Yatekii/pebble/hardware/pebble.kicad_pcb

## KiCad design hardware/pebble.kicad_pcb (2025-12-16)

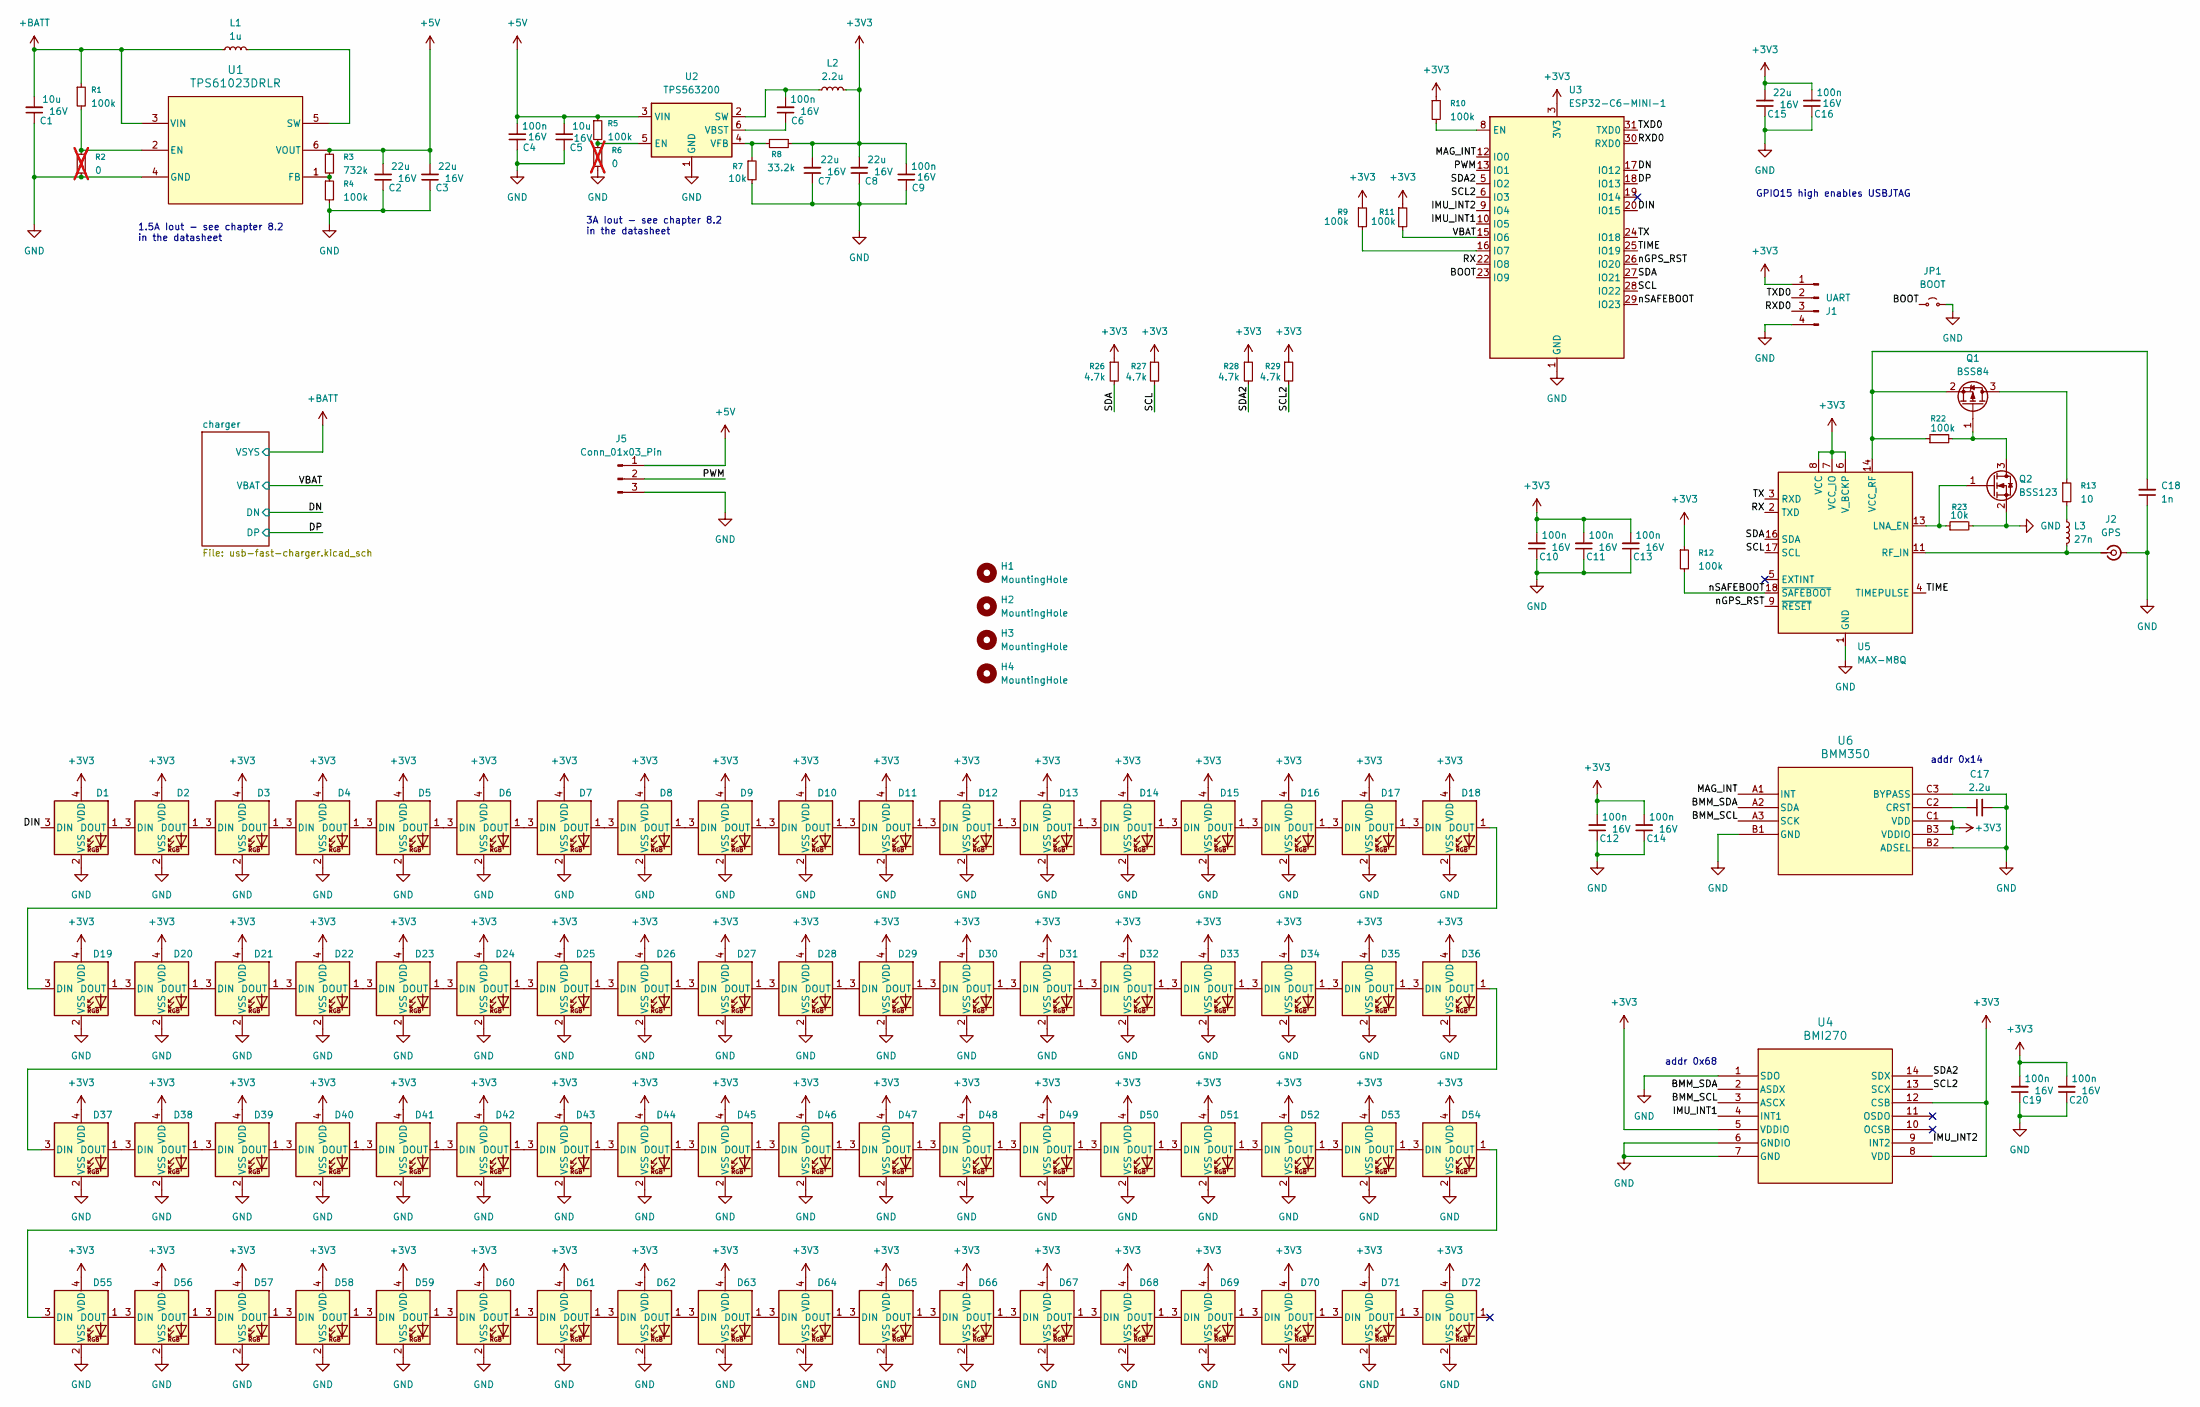
[picture p1: schematic pebble.kicad_sch]

Parts:
C1, C5: 10u; C_0603_1608Metric; Rating 16V
C2, C3, C7, C8, C15: 22u; C_0603_1608Metric; Rating 16V
C4, C6, C9, C10, C11, C12, C13, C14, C16, C19, C20: 100n; C_0402_1005Metric; Rating 16V
C17: 2.2u; C_0402_1005Metric
C18: 1n; C_0402_1005Metric
D1: WS2812B-2020; LED_WS2812B-2020_PLCC4_2.0x2.0mm; LCSC Part # C965555
D2, D3, D4, D5, D6, D7, D8, D9, D10, D11, D12, D13, D14, D15, D16, D17, D18, D19, D20, D21, D22, D23, D24, D25, D26, D27, D28, D29, D30, D31, D32, D33, D34, D35, D36, D37, D38, D39, D40, D41, D42, D43, D44, D45, D46, D47, D48, D49, D50, D51, D52, D53, D54, D55, D56, D57, D58, D59, D60, D61, D62, D63, D64, D65, D66, D67, D68, D69, D70, D71, D72: WS2812B-2020; LED_WS2812B-2020_PLCC4_2.0x2.0mm
H1, H2, H3, H4: MountingHole; MountingHole_3.2mm_M3
J1: UART; PinHeader_1x04_P1.27mm_Vertical
J2: GPS; U.FL_Molex_MCRF_73412-0110_Vertical; LCSC Part # C22418213
J5: Conn_01x03_Pin; PinHeader_1x03_P1.27mm_Horizontal
JP1: BOOT; TestPoint_2Pads_Pitch2.54mm_Drill0.8mm
L1: 1u; L_Coilcraft_XxL4040; Part XEL4030-102MEC
L2: 2.2u; IND_SPM6530_TDK
L3: 27n; L_0402_1005Metric_Pad0.77x0.64mm_HandSolder; Part LQG15HS27NJ02
Q1: BSS84; SOT-23; LCSC Part # Part # C7420340
Q2: BSS123; SOT-23; LCSC Part # C7420338
R1, R4, R5, R9, R10, R11, R12, R22: 100k; R_0402_1005Metric
R2, R6: 0; R_0402_1005Metric; not fitted
R3: 732k; R_0402_1005Metric
R7, R23: 10k; R_0402_1005Metric
R8: 33.2k; R_0402_1005Metric
R13: 10; R_0402_1005Metric
R26, R27, R28, R29: 4.7k; R_0402_1005Metric
U1: TPS61023DRLR; SOT-563; LCSC Part # C919459
U2: TPS563200; SOT-23-6; Part SPM6530T-2R2M; LCSC Part # C97253
U3: ESP32-C6-MINI-1; LCSC Part # C5736265
U4: BMI270; BMI270_BOS; LCSC Part # C2836813
U5: MAX-M8Q; ublox_MAX; LCSC Part # C6898733
U6: BMM350; BGA9_BMM350_BOS; LCSC Part # C17225907

Connections:
+3V3: C7.2, C8.2, C9.2, C10.2, C11.2, C12.2, C13.2, C14.2, C15.2, C16.2, C19.2, C20.2, D1.4 (VDD), D2.4 (VDD), D3.4 (VDD), D4.4 (VDD), D5.4 (VDD), D6.4 (VDD), D7.4 (VDD), D8.4 (VDD), D9.4 (VDD), D10.4 (VDD), D11.4 (VDD), D12.4 (VDD), D13.4 (VDD), D14.4 (VDD), D15.4 (VDD), D16.4 (VDD), D17.4 (VDD), D18.4 (VDD), D19.4 (VDD), D20.4 (VDD), D21.4 (VDD), D22.4 (VDD), D23.4 (VDD), D24.4 (VDD), D25.4 (VDD), D26.4 (VDD), D27.4 (VDD), D28.4 (VDD), D29.4 (VDD), D30.4 (VDD), D31.4 (VDD), D32.4 (VDD), D33.4 (VDD), D34.4 (VDD), D35.4 (VDD), D36.4 (VDD), D37.4 (VDD), D38.4 (VDD), D39.4 (VDD), D40.4 (VDD), D41.4 (VDD), D42.4 (VDD), D43.4 (VDD), D44.4 (VDD), D45.4 (VDD), D46.4 (VDD), D47.4 (VDD), D48.4 (VDD), D49.4 (VDD), D50.4 (VDD), D51.4 (VDD), D52.4 (VDD), D53.4 (VDD), D54.4 (VDD), D55.4 (VDD), D56.4 (VDD), D57.4 (VDD), D58.4 (VDD), D59.4 (VDD), D60.4 (VDD), D61.4 (VDD), D62.4 (VDD), D63.4 (VDD), D64.4 (VDD), D65.4 (VDD), D66.4 (VDD), D67.4 (VDD), D68.4 (VDD), D69.4 (VDD), D70.4 (VDD), D71.4 (VDD), D72.4 (VDD), J1.1, L2.2, R8.1, R9.1, R10.1, R11.1, R12.1, R26.1, R27.1, R28.1, R29.1, U3.3 (3V3), U4.5 (VDDIO), U4.8 (VDD), U4.12 (CSB), U5.6 (V_BCKP), U5.7 (VCC_IO), U5.8 (VCC), U6.B3 (VDDIO), U6.C1 (VDD); also elsewhere on the board
+5V: C2.2, C3.2, C4.2, C5.2, J5.1, R3.1, R5.1, U1.6 (VOUT), U2.3 (VIN)
+BATT: C1.2, L1.1, R1.1, U1.3 (VIN); also elsewhere on the board
/BMM_SCL: U4.3 (ASCX), U6.A3 (SCK)
/BMM_SDA: U4.2 (ASDX), U6.A2 (SDA)
/BOOT: JP1.1 (A), U3.23 (IO9)
/DIN: D1.3 (DIN), U3.20 (IO15)
/DN: U3.17 (IO12); also elsewhere on the board
/DP: U3.18 (IO13); also elsewhere on the board
/IMU_INT1: U3.10 (IO5), U4.4 (INT1)
/IMU_INT2: U3.9 (IO4), U4.9 (INT2)
/MAG_INT: U3.12 (IO0), U6.A1 (INT)
/PWM: J5.2, U3.13 (IO1)
/RX: U3.22 (IO8), U5.2 (TXD)
/RXD0: J1.3, U3.30 (RXD0)
/SCL: R27.2, U3.28 (IO22), U5.17 (SCL)
/SCL2: R29.2, U3.6 (IO3), U4.13 (SCX)
/SDA: R26.2, U3.27 (IO21), U5.16 (SDA)
/SDA2: R28.2, U3.5 (IO2), U4.14 (SDX)
/TIME: U3.25 (IO19), U5.4 (TIMEPULSE)
/TX: U3.24 (IO18), U5.3 (RXD)
/TXD0: J1.2, U3.31 (TXD0)
/VBAT: R11.2, U3.15 (IO6); also elsewhere on the board
/nGPS_RST: U3.26 (IO20), U5.9 (~RESET)
/nSAFEBOOT: R12.2, U3.29 (IO23), U5.18 (~SAFEBOOT)
GND: C1.1, C2.1, C3.1, C4.1, C5.1, C7.1, C8.1, C9.1, C10.1, C11.1, C12.1, C13.1, C14.1, C15.1, C16.1, C17.2, C18.1, C19.1, C20.1, D1.2 (VSS), D2.2 (VSS), D3.2 (VSS), D4.2 (VSS), D5.2 (VSS), D6.2 (VSS), D7.2 (VSS), D8.2 (VSS), D9.2 (VSS), D10.2 (VSS), D11.2 (VSS), D12.2 (VSS), D13.2 (VSS), D14.2 (VSS), D15.2 (VSS), D16.2 (VSS), D17.2 (VSS), D18.2 (VSS), D19.2 (VSS), D20.2 (VSS), D21.2 (VSS), D22.2 (VSS), D23.2 (VSS), D24.2 (VSS), D25.2 (VSS), D26.2 (VSS), D27.2 (VSS), D28.2 (VSS), D29.2 (VSS), D30.2 (VSS), D31.2 (VSS), D32.2 (VSS), D33.2 (VSS), D34.2 (VSS), D35.2 (VSS), D36.2 (VSS), D37.2 (VSS), D38.2 (VSS), D39.2 (VSS), D40.2 (VSS), D41.2 (VSS), D42.2 (VSS), D43.2 (VSS), D44.2 (VSS), D45.2 (VSS), D46.2 (VSS), D47.2 (VSS), D48.2 (VSS), D49.2 (VSS), D50.2 (VSS), D51.2 (VSS), D52.2 (VSS), D53.2 (VSS), D54.2 (VSS), D55.2 (VSS), D56.2 (VSS), D57.2 (VSS), D58.2 (VSS), D59.2 (VSS), D60.2 (VSS), D61.2 (VSS), D62.2 (VSS), D63.2 (VSS), D64.2 (VSS), D65.2 (VSS), D66.2 (VSS), D67.2 (VSS), D68.2 (VSS), D69.2 (VSS), D70.2 (VSS), D71.2 (VSS), D72.2 (VSS), J1.4, J2.2 (Ext), J5.3, JP1.2 (B), Q2.2 (S), R2.2, R4.2, R6.2, R7.2, R23.2, U1.4 (GND), U2.1 (GND), U3.1 (GND), U3.2 (GND), U3.11 (GND), U3.14 (GND), U3.36 (GND), U3.37 (GND), U3.38 (GND), U3.39 (GND), U3.40 (GND), U3.41 (GND), U3.42 (GND), U3.43 (GND), U3.44 (GND), U3.45 (GND), U3.46 (GND), U3.47 (GND), U3.48 (GND), U3.49 (GND), U3.50 (GND), U3.51 (GND), U3.52 (GND), U3.53 (GND), U4.1 (SDO), U4.6 (GNDIO), U4.7 (GND), U5.1 (GND), U5.10 (GND), U5.12 (GND), U6.B1 (GND), U6.B2 (ADSEL), U6.C3 (BYPASS); also elsewhere on the board
unnamed: D1.1 (DOUT), D2.3 (DIN)
unnamed: D2.1 (DOUT), D3.3 (DIN)
unnamed: D3.1 (DOUT), D4.3 (DIN)
unnamed: D4.1 (DOUT), D5.3 (DIN)
unnamed: D5.1 (DOUT), D6.3 (DIN)
unnamed: D6.1 (DOUT), D7.3 (DIN)
unnamed: D7.1 (DOUT), D8.3 (DIN)
unnamed: D8.1 (DOUT), D9.3 (DIN)
unnamed: D9.1 (DOUT), D10.3 (DIN)
unnamed: D10.1 (DOUT), D11.3 (DIN)
unnamed: D11.1 (DOUT), D12.3 (DIN)
unnamed: D12.1 (DOUT), D13.3 (DIN)
unnamed: D13.1 (DOUT), D14.3 (DIN)
unnamed: D14.1 (DOUT), D15.3 (DIN)
unnamed: D15.1 (DOUT), D16.3 (DIN)
unnamed: D16.1 (DOUT), D17.3 (DIN)
unnamed: D17.1 (DOUT), D18.3 (DIN)
unnamed: D18.1 (DOUT), D19.3 (DIN)
unnamed: D19.1 (DOUT), D20.3 (DIN)
unnamed: D20.1 (DOUT), D21.3 (DIN)
unnamed: D21.1 (DOUT), D22.3 (DIN)
unnamed: D22.1 (DOUT), D23.3 (DIN)
unnamed: D23.1 (DOUT), D24.3 (DIN)
unnamed: D24.1 (DOUT), D25.3 (DIN)
unnamed: D25.1 (DOUT), D26.3 (DIN)
unnamed: D26.1 (DOUT), D27.3 (DIN)
unnamed: D27.1 (DOUT), D28.3 (DIN)
unnamed: D28.1 (DOUT), D29.3 (DIN)
unnamed: D29.1 (DOUT), D30.3 (DIN)
unnamed: D30.1 (DOUT), D31.3 (DIN)
unnamed: D31.1 (DOUT), D32.3 (DIN)
unnamed: D32.1 (DOUT), D33.3 (DIN)
unnamed: D33.1 (DOUT), D34.3 (DIN)
unnamed: D34.1 (DOUT), D35.3 (DIN)
unnamed: D35.1 (DOUT), D36.3 (DIN)
unnamed: D36.1 (DOUT), D37.3 (DIN)
unnamed: D37.1 (DOUT), D38.3 (DIN)
unnamed: D38.1 (DOUT), D39.3 (DIN)
unnamed: D39.1 (DOUT), D40.3 (DIN)
unnamed: D40.1 (DOUT), D41.3 (DIN)
unnamed: D41.1 (DOUT), D42.3 (DIN)
unnamed: D42.1 (DOUT), D43.3 (DIN)
unnamed: D43.1 (DOUT), D44.3 (DIN)
unnamed: D44.1 (DOUT), D45.3 (DIN)
unnamed: D45.1 (DOUT), D46.3 (DIN)
unnamed: D46.1 (DOUT), D47.3 (DIN)
unnamed: D47.1 (DOUT), D48.3 (DIN)
unnamed: D48.1 (DOUT), D49.3 (DIN)
unnamed: D49.1 (DOUT), D50.3 (DIN)
unnamed: D50.1 (DOUT), D51.3 (DIN)
unnamed: D51.1 (DOUT), D52.3 (DIN)
unnamed: D52.1 (DOUT), D53.3 (DIN)
unnamed: D53.1 (DOUT), D54.3 (DIN)
unnamed: D54.1 (DOUT), D55.3 (DIN)
unnamed: D55.1 (DOUT), D56.3 (DIN)
unnamed: D56.1 (DOUT), D57.3 (DIN)
unnamed: D57.1 (DOUT), D58.3 (DIN)
unnamed: D58.1 (DOUT), D59.3 (DIN)
unnamed: D59.1 (DOUT), D60.3 (DIN)
unnamed: D60.1 (DOUT), D61.3 (DIN)
unnamed: D61.1 (DOUT), D62.3 (DIN)
unnamed: D62.1 (DOUT), D63.3 (DIN)
unnamed: D63.1 (DOUT), D64.3 (DIN)
unnamed: D64.1 (DOUT), D65.3 (DIN)
unnamed: D65.1 (DOUT), D66.3 (DIN)
unnamed: D66.1 (DOUT), D67.3 (DIN)
unnamed: D67.1 (DOUT), D68.3 (DIN)
unnamed: D68.1 (DOUT), D69.3 (DIN)
unnamed: D69.1 (DOUT), D70.3 (DIN)
unnamed: D70.1 (DOUT), D71.3 (DIN)
unnamed: D71.1 (DOUT), D72.3 (DIN)
unnamed: J2.1 (In), L3.2, U5.11 (RF_IN)
unnamed: L3.1, R13.2
unnamed: Q1.3 (D), R13.1
unnamed: Q1.1 (G), Q2.3 (D), R22.2
unnamed: C18.2, Q1.2 (S), R22.1, U5.14 (VCC_RF)
unnamed: Q2.1 (G), R23.1, U5.13 (LNA_EN)
unnamed: R1.2, R2.1, U1.2 (EN)
unnamed: R3.2, R4.1, U1.1 (FB)
unnamed: L1.2, U1.5 (SW)
unnamed: R5.2, R6.1, U2.5 (EN)
unnamed: C6.2, L2.1, U2.2 (SW)
unnamed: C6.1, U2.6 (VBST)
unnamed: R7.1, R8.2, U2.4 (VFB)
unnamed: R10.2, U3.8 (EN)
unnamed: R9.2, U3.16 (IO7)
unnamed: C17.1, U6.C2 (CRST)

Notes on the sheet:
addr 0x14
GPIO15 high enables USBJTAG
3A Iout - see chapter 8.2 in the datasheet
1.5A Iout - see chapter 8.2 in the datasheet
addr 0x68

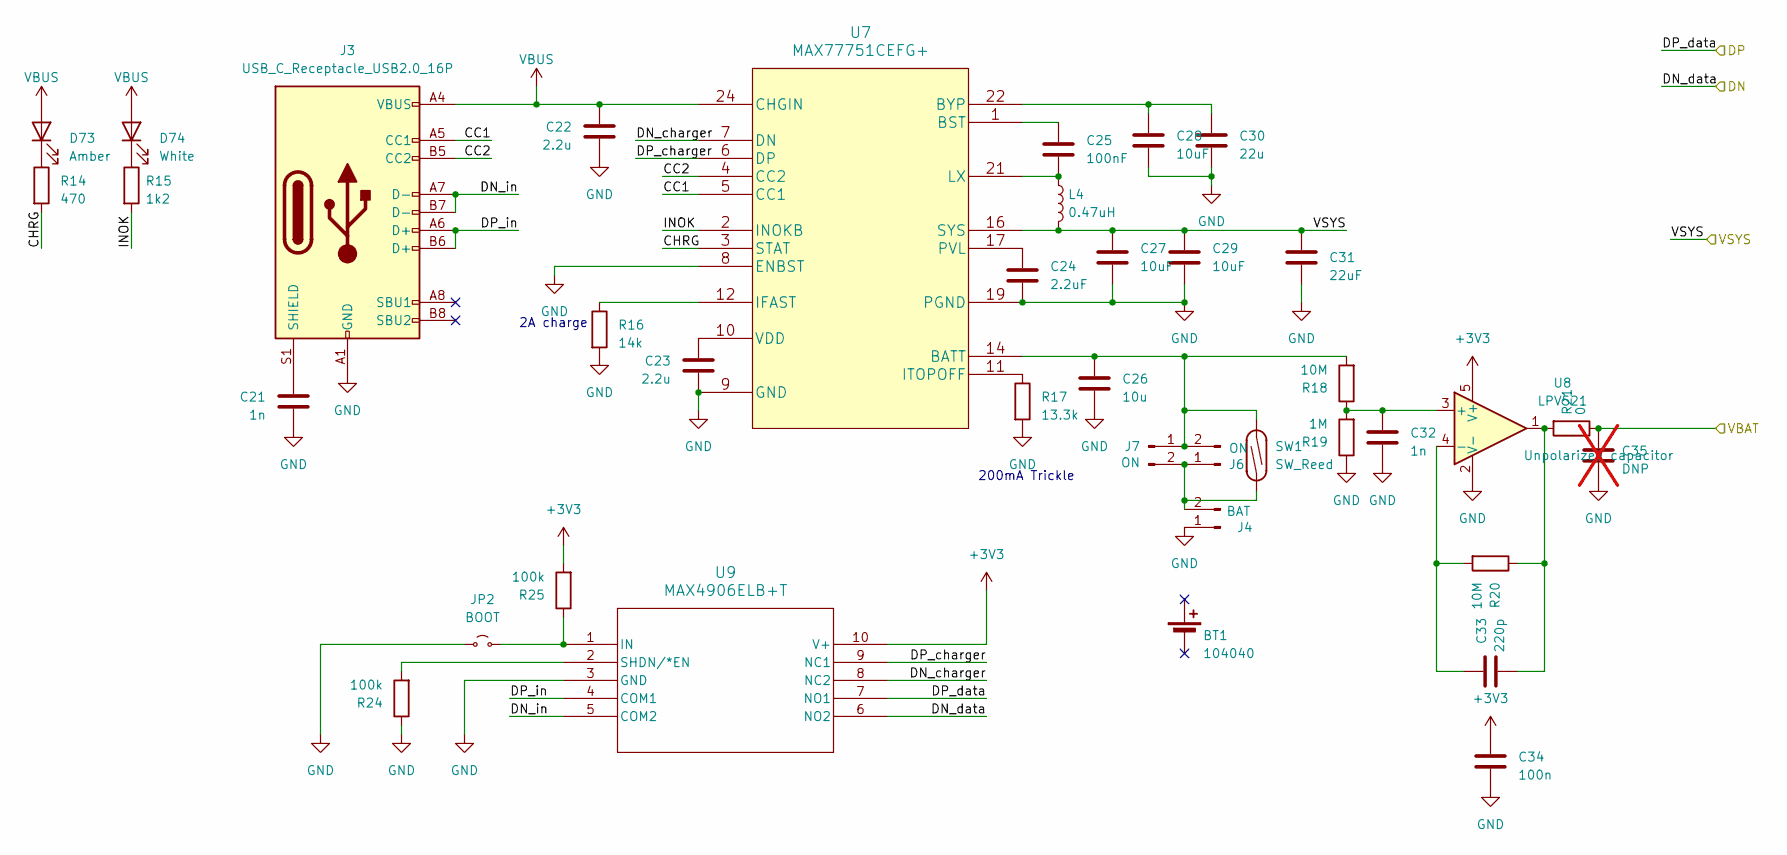
[picture p2: schematic usb-fast-charger.kicad_sch]

Parts:
BT1: 104040; JST_PH_S2B-PH-SM4-TB_1x02-1MP_P2.00mm_Horizontal
C21: 1n; C_1206_3216Metric; Voltage 2000; Mouser 80-C1206C102KGR
C22, C23: 2.2u; C_0402_1005Metric; Voltage 16; Mouser 346-CM05X5R225M16AH
C24: 2.2uF; C_0402_1005Metric; Voltage 16; Mouser 346-CM05X5R225M16AH
C25: 100nF; C_0402_1005Metric; Voltage 25V
C26: 10u; C_0805_2012Metric; Voltage 16; Mouser 187-CL21A106KOQNNNE
C27, C28, C29: 10uF; C_0805_2012Metric; Voltage 16; Mouser 187-CL21A106KOQNNNE
C30: 22u; C_0805_2012Metric; Voltage 16; Mouser 187-CL21A226MOQNNNE
C31: 22uF; C_0805_2012Metric; Voltage 16; Mouser 187-CL21A226MOQNNNE
C32: 1n; C_0402_1005Metric; Voltage 25V
C33: 220p; C_0402_1005Metric; Voltage 25V
C34: 100n; C_0402_1005Metric; Voltage 25V
C35: DNP; C_0402_1005Metric; Voltage 25V; not fitted
D73: Amber; LED_0603_1608Metric; Mouser 710-150060AS75000
D74: White; LED_0603_1608Metric; Mouser 78-VLMW1300-GS08
J3: USB_C_Receptacle_USB2.0_16P; USB_C_Receptacle_G-Switch_GT-USB-7051x; LCSC Part # C2843970
J4: BAT; PinHeader_1x02_P1.27mm_Vertical
J6, J7: ON; PinHeader_1x02_P1.27mm_Vertical
JP2: BOOT; TestPoint_2Pads_Pitch2.54mm_Drill0.8mm
L4: 0.47uH; IND_SRP2512TMA_BRN; Mouser 652-SRP2512TMA-R47M
R14: 470; R_0402_1005Metric
R15: 1k2; R_0402_1005Metric
R16: 14k; R_0402_1005Metric; Mouser 603-AC0402FR-0714KL
R17: 13.3k; R_0402_1005Metric; Mouser 603-RC0402FR-0713K3L
R18, R20: 10M; R_0402_1005Metric; Mouser 603-AC0402FR-0710ML
R19: 1M; R_0402_1005Metric; Mouser 603-AC0402FR-071ML
R21: 0; R_0402_1005Metric
R24, R25: 100k; R_0402_1005Metric; Mouser 603-AC0402FR-071ML
SW1: SW_Reed; 59170-1-S-00-D; LCSC Part # C315909
U7: MAX77751CEFG+; LCSC Part # C2908590
U8: LPV521; SOT-23-5; LCSC Part # C779403
U9: MAX4906ELB+T; 21-0164_L1022&plus_1_MXM; LCSC Part # C2150885

Connections:
+3V3: C34.1, R25.2, U8.5 (V+), U9.10 (V+); also elsewhere on the board
+BATT: C27.1, C29.1, C31.1, L4.2, U7.15 (SYS), U7.16 (SYS); also elsewhere on the board
/DN: U9.6 (NO2); also elsewhere on the board
/DP: U9.7 (NO1); also elsewhere on the board
/VBAT: C35.1, R21.1; also elsewhere on the board
/charger/CC1: J3.A5 (CC1), U7.5 (CC1)
/charger/CC2: J3.B5 (CC2), U7.4 (CC2)
/charger/CHRG: R14.2, U7.3 (STAT)
/charger/DN_charger: U7.7 (DN), U9.8 (NC2)
/charger/DN_in: J3.A7 (D-), J3.B7 (D-), U9.5 (COM2)
/charger/DP_charger: U7.6 (DP), U9.9 (NC1)
/charger/DP_in: J3.A6 (D+), J3.B6 (D+), U9.4 (COM1)
/charger/INOK: R15.2, U7.2 (INOKB)
GND: C21.2, C22.2, C23.2, C24.2, C26.2, C27.2, C28.2, C29.2, C30.2, C31.2, C32.2, C34.2, C35.2, J3.A1 (GND), J3.A12 (GND), J3.B1 (GND), J3.B12 (GND), J4.1, JP2.1 (A), R16.2, R17.2, R19.1, R24.1, U7.8 (ENBST), U7.9 (GND), U7.18 (PGND), U7.19 (PGND), U8.2 (V-), U9.3 (GND); also elsewhere on the board
unnamed: C25.2, L4.1, U7.20 (LX), U7.21 (LX)
unnamed: C33.1, R20.1, R21.2, U8.1
unnamed: D73.1 (K), R14.1
unnamed: D74.1 (K), R15.1
unnamed: C21.1, J3.S1 (SHIELD)
unnamed: J4.2, J6.1, J7.2, SW1.2
unnamed: C26.1, J6.2, J7.1, R18.2, SW1.1, U7.13 (BATT), U7.14 (BATT)
unnamed: JP2.2 (B), R25.1, U9.1 (IN)
unnamed: C25.1, U7.1 (BST)
unnamed: C28.1, C30.1, U7.22 (BYP)
unnamed: R16.1, U7.12 (IFAST)
unnamed: R17.1, U7.11 (ITOPOFF)
unnamed: C24.1, U7.17 (PVL)
unnamed: C23.1, U7.10 (VDD)
unnamed: C32.1, R18.1, R19.2, U8.3 (+)
unnamed: C33.2, R20.2, U8.4 (-)
unnamed: R24.2, U9.2 (SHDN/*EN)
VBUS: C22.1, D73.2 (A), D74.2 (A), J3.A4 (VBUS), J3.A9 (VBUS), J3.B4 (VBUS), J3.B9 (VBUS), U7.23 (CHGIN), U7.24 (CHGIN)

Notes on the sheet:
200mA Trickle
2A charge

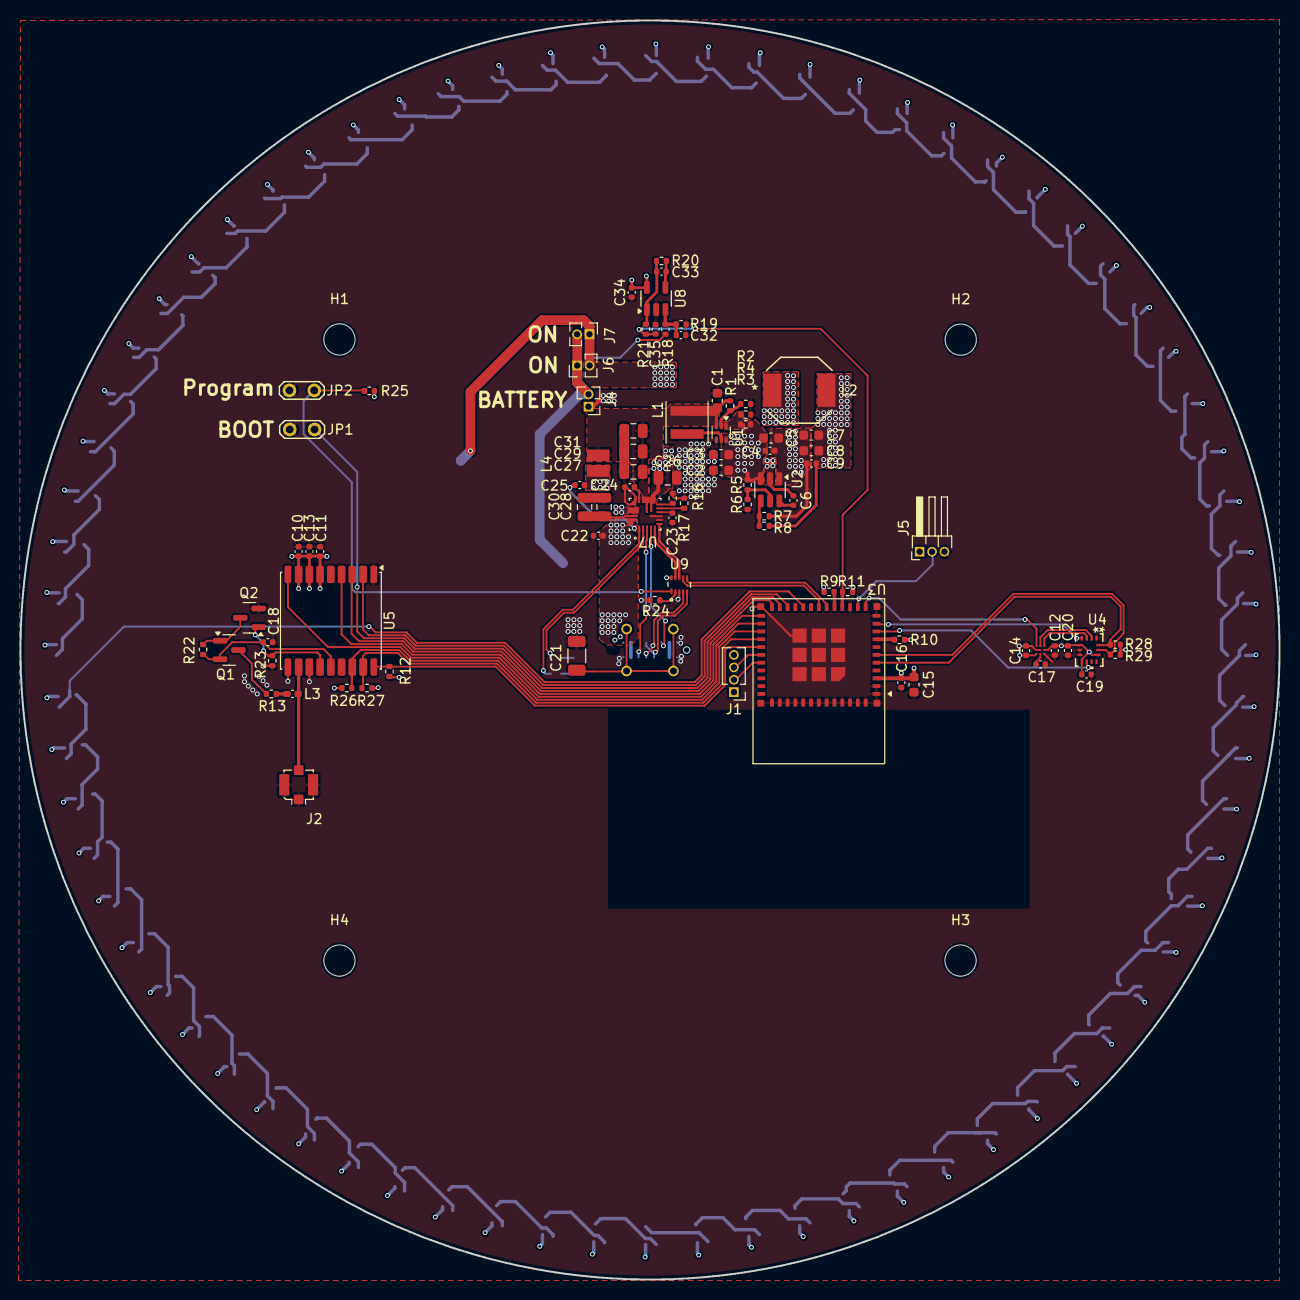
[picture p3: board pebble.kicad_pcb from above]

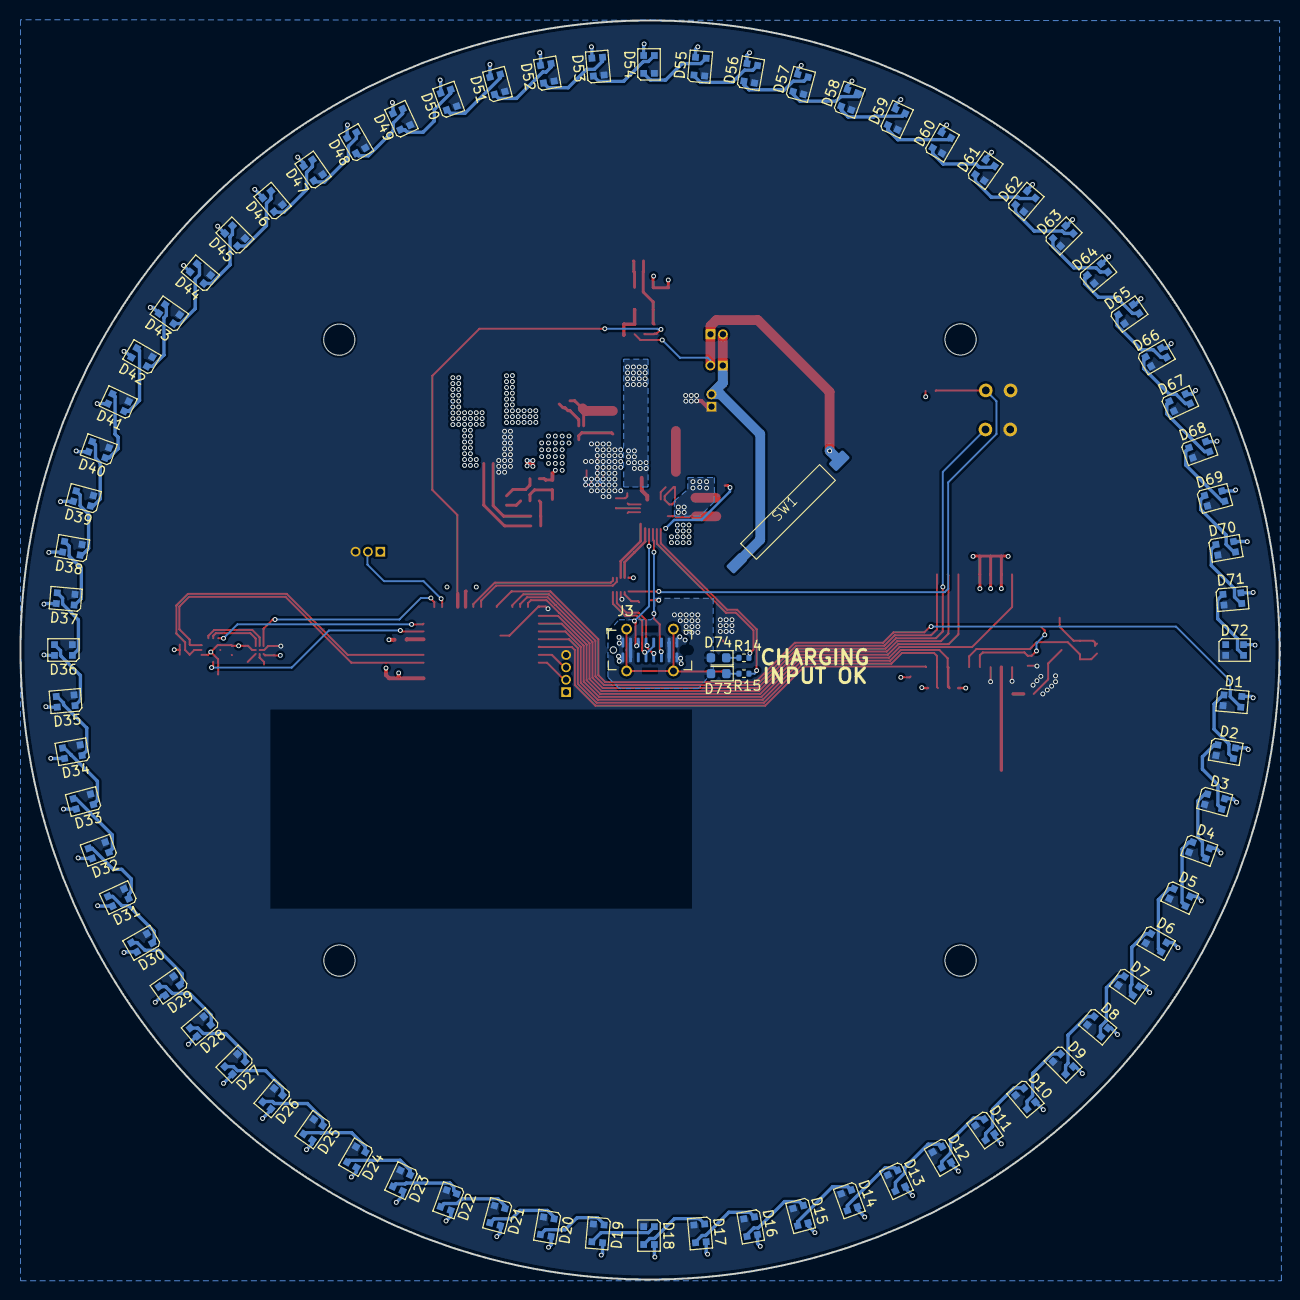
[picture p4: board pebble.kicad_pcb from below]

Board: 4 copper layers, 129.0 x 129.0 mm, 167 parts (78 on the bottom side), 139 nets.
