Yatekii/pebble/firmware/src/hal/gps.rs

//! GPS driver for MAX-M8Q module
//!
//! Datasheet: https://www.u-blox.com/sites/default/files/MAX-M8-FW3_DataSheet_%28UBX-15031506%29.pdf
//!
//! The GPS communicates via UART at 9600 baud (default).
//! GPIO8 = RX (from GPS TXD), GPIO18 = TX (to GPS RXD).
//! This module handles UART communication and uses the `nmea` crate for parsing.

use chrono::{Datelike, Timelike};
use defmt::Format;
use esp_hal::Blocking;
use esp_hal::uart::{Config as UartConfig, RxConfig, TxConfig, Uart};
use nmea::Nmea;
use nmea::SentenceType;
use nmea::sentences::FixType as NmeaFixType;

/// GPS driver using FIFO polling
pub struct Gps<'d> {
    _uart: Uart<'d, Blocking>,
    nmea: Nmea,
    ubx_parser: UbxParser,
    line_buffer: [u8; 128],
    line_pos: usize,
}

impl<'d> Gps<'d> {
    /// Poll FIFO and parse any available GPS data
    /// Returns Some(GpsData) when a complete sentence updates the fix
    pub fn poll(&mut self) -> Option<GpsData> {
        let uart1 = unsafe { &*esp_hal::peripherals::UART1::ptr() };

        let mut result = None;
        while uart1.status().read().rxfifo_cnt().bits() > 0 {
            let byte = uart1.fifo().read().rxfifo_rd_byte().bits();

            // Try UBX parsing for binary responses
            self.ubx_parser.process(byte);

            // Buffer NMEA sentences
            if byte == b'$' {
                self.line_pos = 0;
            }

            if self.line_pos < self.line_buffer.len() {
                self.line_buffer[self.line_pos] = byte;
                self.line_pos += 1;
            }

            // Check for end of NMEA sentence
            if byte == b'\n' && self.line_pos > 1 {
                if let Ok(sentence) = core::str::from_utf8(&self.line_buffer[..self.line_pos]) {
                    let sentence = sentence.trim();

                    // Fix GSV sentences with 0 satellites - nmea crate expects trailing comma
                    // e.g., "$GPGSV,1,1,00*79" -> "$GPGSV,1,1,00,*XX" with recalculated checksum
                    let mut fixed_buf = [0u8; 140];
                    let parse_sentence = if sentence.contains("GSV") && sentence.contains(",00*") {
                        if let Some(star_idx) = sentence.find('*') {
                            // Get data between $ and *, add comma after it
                            let data = &sentence[1..star_idx];
                            let new_data_len = data.len() + 1; // +1 for added comma

                            // Build: $<data>,*<checksum>
                            fixed_buf[0] = b'$';
                            fixed_buf[1..1 + data.len()].copy_from_slice(data.as_bytes());
                            fixed_buf[1 + data.len()] = b',';
                            fixed_buf[2 + data.len()] = b'*';

                            // Calculate new checksum (XOR of bytes between $ and *)
                            let mut checksum: u8 = 0;
                            for &b in &fixed_buf[1..1 + new_data_len] {
                                checksum ^= b;
                            }

                            // Write checksum as hex
                            let hex_chars = b"0123456789ABCDEF";
                            fixed_buf[3 + data.len()] = hex_chars[(checksum >> 4) as usize];
                            fixed_buf[4 + data.len()] = hex_chars[(checksum & 0xF) as usize];

                            let total_len = 5 + data.len();
                            core::str::from_utf8(&fixed_buf[..total_len]).unwrap_or(sentence)
                        } else {
                            sentence
                        }
                    } else {
                        sentence
                    };

                    match self.nmea.parse(parse_sentence) {
                        Ok(_) => {
                            result = Some(self.to_gps_data());
                        }
                        Err(e) => {
                            defmt::warn!(
                                "NMEA parse error for '{}': {:?}",
                                sentence,
                                defmt::Debug2Format(&e)
                            );
                        }
                    }
                }
                self.line_pos = 0;
            }
        }

        result
    }

    /// Get the current GPS data
    pub fn data(&self) -> GpsData {
        self.to_gps_data()
    }

    /// Convert nmea state to GpsData
    fn to_gps_data(&self) -> GpsData {
        use nmea::sentences::GnssType as NmeaGnssType;

        let fix_quality = match self.nmea.fix_type {
            Some(NmeaFixType::Invalid) | None => FixQuality::Invalid,
            Some(NmeaFixType::Gps) => FixQuality::GpsFix,
            Some(NmeaFixType::DGps) => FixQuality::DgpsFix,
            Some(NmeaFixType::Pps) => FixQuality::PpsFix,
            Some(NmeaFixType::Rtk) => FixQuality::RtkFixed,
            Some(NmeaFixType::FloatRtk) => FixQuality::RtkFloat,
            Some(NmeaFixType::Estimated) => FixQuality::Estimated,
            Some(NmeaFixType::Manual) => FixQuality::Manual,
            Some(NmeaFixType::Simulation) => FixQuality::Simulation,
        };

        // Determine fix type from HDOP/altitude availability as proxy for 2D/3D
        let fix_type = if self.nmea.hdop.is_some() && self.nmea.altitude.is_some() {
            FixType::Fix3D
        } else if self.nmea.hdop.is_some() {
            FixType::Fix2D
        } else {
            FixType::NoFix
        };

        // Get satellites from GSV data
        let nmea_sats = self.nmea.satellites();
        let satellites_in_view = nmea_sats.len().min(MAX_SATELLITES) as u8;

        // Convert satellite info
        let mut satellites_info = [SatelliteInfo::default(); MAX_SATELLITES];
        for (i, sat) in nmea_sats.iter().take(MAX_SATELLITES).enumerate() {
            let gnss_type = match sat.gnss_type() {
                NmeaGnssType::Gps => GnssType::Gps,
                NmeaGnssType::Glonass => GnssType::Glonass,
                NmeaGnssType::Galileo => GnssType::Galileo,
                NmeaGnssType::Beidou => GnssType::BeiDou,
                NmeaGnssType::Qzss => GnssType::Qzss,
                NmeaGnssType::NavIC => GnssType::Unknown,
            };
            satellites_info[i] = SatelliteInfo {
                gnss_type,
                prn: sat.prn() as u8,
                elevation: sat.elevation().unwrap_or(0.0) as u8,
                azimuth: sat.azimuth().unwrap_or(0.0) as u16,
                snr: sat.snr().unwrap_or(0.0) as u8,
            };
        }

        // Use satellites in view if no fix satellites reported
        let satellites = self
            .nmea
            .num_of_fix_satellites
            .map(|n| n as u8)
            .unwrap_or(satellites_in_view);

        GpsData {
            position: Position {
                latitude: self.nmea.latitude.map(|l| l as f32).unwrap_or(0.0),
                longitude: self.nmea.longitude.map(|l| l as f32).unwrap_or(0.0),
                altitude: self.nmea.altitude.unwrap_or(0.0),
                fix_quality,
                satellites,
                hdop: self.nmea.hdop.unwrap_or(99.9),
            },
            time: self
                .nmea
                .fix_time
                .map(|t| Time {
                    hours: t.hour() as u8,
                    minutes: t.minute() as u8,
                    seconds: t.second() as u8,
                    milliseconds: (t.nanosecond() / 1_000_000) as u16,
                })
                .unwrap_or_default(),
            date: self
                .nmea
                .fix_date
                .map(|d| Date {
                    day: d.day() as u8,
                    month: d.month() as u8,
                    year: d.year() as u16,
                })
                .unwrap_or_default(),
            speed_knots: self.nmea.speed_over_ground.unwrap_or(0.0),
            course: self.nmea.true_course.unwrap_or(0.0),
            fix_type,
            satellites_info,
            satellites_in_view,
        }
    }
}

/// Initialize GPS UART on GPIO8 (RX) and GPIO18 (TX)
pub fn init(
    uart: esp_hal::peripherals::UART1<'static>,
    rx: esp_hal::peripherals::GPIO8<'static>,
    tx: esp_hal::peripherals::GPIO18<'static>,
) -> Result<Gps<'static>, esp_hal::uart::ConfigError> {
    defmt::info!("GPS: configuring UART1 at 9600 baud");
    let config = UartConfig::default()
        .with_baudrate(9600)
        .with_rx(RxConfig::default())
        .with_tx(TxConfig::default());

    let mut uart = Uart::new(uart, config)?.with_rx(rx).with_tx(tx);

    // Reset GPS to factory defaults using CFG-CFG
    // clearMask = 0x1F (all sections), loadMask = 0x1F (all sections), deviceMask = 0x17 (all)
    #[rustfmt::skip]
    let mut cfg_cfg_reset: [u8; 21] = [
        0xB5, 0x62,             // Sync
        0x06, 0x09,             // Class/ID: CFG-CFG
        0x0D, 0x00,             // Length: 13 bytes
        0x1F, 0x00, 0x00, 0x00, // clearMask: all sections
        0x00, 0x00, 0x00, 0x00, // saveMask: none
        0x1F, 0x00, 0x00, 0x00, // loadMask: all sections (load defaults)
        0x17,                   // deviceMask: BBR, Flash, EEPROM, SPI
        0x00, 0x00,             // Checksum placeholder
    ];
    let (ck_a, ck_b) = ubx_checksum(&cfg_cfg_reset[2..19]);
    cfg_cfg_reset[19] = ck_a;
    cfg_cfg_reset[20] = ck_b;

    defmt::info!("GPS: resetting to factory defaults");
    let _ = embedded_io::Write::write_all(&mut uart, &cfg_cfg_reset);

    // Wait for reset to complete
    for _ in 0..500000 {
        core::hint::spin_loop();
    }

    // Configure antenna supervisor via CFG-ANT
    let flags: u16 = 0x0001; // svcs only - antenna voltage control
    let pins: u16 = 0x0000; // Use dedicated LNA_EN pin

    let mut cfg_ant: [u8; 12] = [
        0xB5,
        0x62,
        0x06,
        0x13,
        0x04,
        0x00,
        (flags & 0xFF) as u8,
        ((flags >> 8) & 0xFF) as u8,
        (pins & 0xFF) as u8,
        ((pins >> 8) & 0xFF) as u8,
        0x00,
        0x00,
    ];
    let (ck_a, ck_b) = ubx_checksum(&cfg_ant[2..10]);
    cfg_ant[10] = ck_a;
    cfg_ant[11] = ck_b;

    defmt::info!("GPS: CFG-ANT flags={:#06x} pins={:#06x}", flags, pins);
    let _ = embedded_io::Write::write_all(&mut uart, &cfg_ant);

    // Small delay
    for _ in 0..100000 {
        core::hint::spin_loop();
    }

    // Save config to flash with CFG-CFG
    let mut cfg_cfg: [u8; 21] = [
        0xB5, 0x62, 0x06, 0x09, 0x0D, 0x00, 0x00, 0x00, 0x00, 0x00, 0x1F, 0x00, 0x00, 0x00, 0x00,
        0x00, 0x00, 0x00, 0x17, 0x00, 0x00,
    ];
    let (ck_a, ck_b) = ubx_checksum(&cfg_cfg[2..19]);
    cfg_cfg[19] = ck_a;
    cfg_cfg[20] = ck_b;

    defmt::info!("GPS: saving config to flash");
    let _ = embedded_io::Write::write_all(&mut uart, &cfg_cfg);

    // Small delay
    for _ in 0..100000 {
        core::hint::spin_loop();
    }

    // Configure GNSS systems via CFG-GNSS (0x06 0x3E)
    // Enable GPS + Galileo + BeiDou (3 concurrent max on MAX-M8Q)
    // Message structure:
    //   - msgVer: 0
    //   - numTrkChHw: 0 (read-only, will be ignored)
    //   - numTrkChUse: 0xFF (use all available channels)
    //   - numConfigBlocks: 7 (must match what module reports)
    //   - Per block: gnssId (1), resTrkCh (1), maxTrkCh (1), reserved (1), flags (4)
    // Total: 2 sync + 2 class/id + 2 length + 4 header + 7*8 blocks + 2 checksum = 68 bytes
    #[rustfmt::skip]
    let mut cfg_gnss: [u8; 68] = [
        0xB5, 0x62,             // Sync
        0x06, 0x3E,             // Class/ID: CFG-GNSS
        0x3C, 0x00,             // Length: 60 bytes (4 header + 7*8 blocks = 60)
        // Header
        0x00,                   // msgVer
        0x00,                   // numTrkChHw (read-only)
        0xFF,                   // numTrkChUse (use all)
        0x07,                   // numConfigBlocks (7 systems)
        // GPS (gnssId=0): Enable with 8-16 channels
        0x00, 0x08, 0x10, 0x00, 0x01, 0x00, 0x01, 0x01,
        // SBAS (gnssId=1): Disable
        0x01, 0x01, 0x03, 0x00, 0x00, 0x00, 0x01, 0x01,
        // Galileo (gnssId=2): Enable with 4-8 channels
        0x02, 0x04, 0x08, 0x00, 0x01, 0x00, 0x01, 0x01,
        // BeiDou (gnssId=3): Enable with 8-16 channels
        0x03, 0x08, 0x10, 0x00, 0x01, 0x00, 0x01, 0x01,
        // IMES (gnssId=4): Disable
        0x04, 0x00, 0x08, 0x00, 0x00, 0x00, 0x03, 0x01,
        // QZSS (gnssId=5): Disable
        0x05, 0x00, 0x03, 0x00, 0x00, 0x00, 0x05, 0x01,
        // GLONASS (gnssId=6): Disable (to make room for Galileo+BeiDou)
        0x06, 0x08, 0x0E, 0x00, 0x00, 0x00, 0x01, 0x01,
        // Checksum placeholder
        0x00, 0x00,
    ];
    let (ck_a, ck_b) = ubx_checksum(&cfg_gnss[2..66]);
    cfg_gnss[66] = ck_a;
    cfg_gnss[67] = ck_b;

    defmt::info!("GPS: enabling GPS + Galileo + BeiDou");
    let _ = embedded_io::Write::write_all(&mut uart, &cfg_gnss);

    // Small delay
    for _ in 0..100000 {
        core::hint::spin_loop();
    }

    // Save GNSS config to flash
    let mut cfg_cfg_save: [u8; 21] = [
        0xB5, 0x62, 0x06, 0x09, 0x0D, 0x00, 0x00, 0x00, 0x00, 0x00, 0x1F, 0x00, 0x00, 0x00, 0x00,
        0x00, 0x00, 0x00, 0x17, 0x00, 0x00,
    ];
    let (ck_a, ck_b) = ubx_checksum(&cfg_cfg_save[2..19]);
    cfg_cfg_save[19] = ck_a;
    cfg_cfg_save[20] = ck_b;

    defmt::info!("GPS: saving GNSS config to flash");
    let _ = embedded_io::Write::write_all(&mut uart, &cfg_cfg_save);

    // Poll antenna status
    let cfg_ant_poll: [u8; 8] = [0xB5, 0x62, 0x06, 0x13, 0x00, 0x00, 0x19, 0x51];
    let _ = embedded_io::Write::write_all(&mut uart, &cfg_ant_poll);

    // Poll MON-HW
    let mon_hw_poll: [u8; 8] = [0xB5, 0x62, 0x0A, 0x09, 0x00, 0x00, 0x13, 0x43];
    let _ = embedded_io::Write::write_all(&mut uart, &mon_hw_poll);

    defmt::info!("GPS: init complete");

    // Create NMEA parser with required sentence types enabled
    let nmea = Nmea::create_for_navigation(&[
        SentenceType::GGA, // Position fix data
        SentenceType::GSA, // DOP and active satellites
        SentenceType::GSV, // Satellites in view
        SentenceType::RMC, // Recommended minimum data
        SentenceType::VTG, // Course over ground
        SentenceType::GLL, // Geographic position
        SentenceType::TXT, // Text messages (status info from GPS)
    ])
    .unwrap_or_default();

    Ok(Gps {
        _uart: uart,
        nmea,
        ubx_parser: UbxParser::new(),
        line_buffer: [0; 128],
        line_pos: 0,
    })
}

/// UBX protocol parser for decoding binary responses
struct UbxParser {
    state: UbxState,
    class: u8,
    id: u8,
    length: u16,
    payload: [u8; 64],
    payload_idx: usize,
    ck_a: u8,
    ck_b: u8,
}

#[derive(Clone, Copy, PartialEq)]
enum UbxState {
    Sync1,
    Sync2,
    Class,
    Id,
    LengthLow,
    LengthHigh,
    Payload,
    ChecksumA,
    ChecksumB,
}

impl UbxParser {
    fn new() -> Self {
        Self {
            state: UbxState::Sync1,
            class: 0,
            id: 0,
            length: 0,
            payload: [0; 64],
            payload_idx: 0,
            ck_a: 0,
            ck_b: 0,
        }
    }

    fn process(&mut self, byte: u8) {
        match self.state {
            UbxState::Sync1 => {
                if byte == 0xB5 {
                    self.state = UbxState::Sync2;
                }
            }
            UbxState::Sync2 => {
                if byte == 0x62 {
                    self.state = UbxState::Class;
                    self.ck_a = 0;
                    self.ck_b = 0;
                } else {
                    self.state = UbxState::Sync1;
                }
            }
            UbxState::Class => {
                self.class = byte;
                self.ck_a = self.ck_a.wrapping_add(byte);
                self.ck_b = self.ck_b.wrapping_add(self.ck_a);
                self.state = UbxState::Id;
            }
            UbxState::Id => {
                self.id = byte;
                self.ck_a = self.ck_a.wrapping_add(byte);
                self.ck_b = self.ck_b.wrapping_add(self.ck_a);
                self.state = UbxState::LengthLow;
            }
            UbxState::LengthLow => {
                self.length = byte as u16;
                self.ck_a = self.ck_a.wrapping_add(byte);
                self.ck_b = self.ck_b.wrapping_add(self.ck_a);
                self.state = UbxState::LengthHigh;
            }
            UbxState::LengthHigh => {
                self.length |= (byte as u16) << 8;
                self.ck_a = self.ck_a.wrapping_add(byte);
                self.ck_b = self.ck_b.wrapping_add(self.ck_a);
                self.payload_idx = 0;
                if self.length == 0 {
                    self.state = UbxState::ChecksumA;
                } else {
                    self.state = UbxState::Payload;
                }
            }
            UbxState::Payload => {
                if self.payload_idx < self.payload.len() {
                    self.payload[self.payload_idx] = byte;
                }
                self.payload_idx += 1;
                self.ck_a = self.ck_a.wrapping_add(byte);
                self.ck_b = self.ck_b.wrapping_add(self.ck_a);
                if self.payload_idx >= self.length as usize {
                    self.state = UbxState::ChecksumA;
                }
            }
            UbxState::ChecksumA => {
                if byte == self.ck_a {
                    self.state = UbxState::ChecksumB;
                } else {
                    defmt::warn!("UBX checksum A mismatch");
                    self.state = UbxState::Sync1;
                }
            }
            UbxState::ChecksumB => {
                if byte == self.ck_b {
                    self.handle_message();
                } else {
                    defmt::warn!("UBX checksum B mismatch");
                }
                self.state = UbxState::Sync1;
            }
        }
    }

    fn handle_message(&self) {
        match (self.class, self.id) {
            (0x06, 0x13) => {
                // CFG-ANT response
                if self.length >= 4 {
                    let flags = self.payload[0] as u16 | ((self.payload[1] as u16) << 8);
                    let pins = self.payload[2] as u16 | ((self.payload[3] as u16) << 8);
                    defmt::info!("UBX CFG-ANT: flags={:#06x} pins={:#06x}", flags, pins);
                }
            }
            (0x05, 0x01) => {
                // ACK-ACK
                if self.length >= 2 {
                    defmt::info!(
                        "UBX ACK for class={:#04x} id={:#04x}",
                        self.payload[0],
                        self.payload[1]
                    );
                }
            }
            (0x05, 0x00) => {
                // ACK-NAK
                if self.length >= 2 {
                    defmt::warn!(
                        "UBX NAK for class={:#04x} id={:#04x}",
                        self.payload[0],
                        self.payload[1]
                    );
                }
            }
            (0x0A, 0x09) => {
                // MON-HW response
                if self.length >= 60 {
                    let a_status = self.payload[20];
                    let a_power = self.payload[21];
                    let status_str = match a_status {
                        0 => "INIT",
                        1 => "DONTKNOW",
                        2 => "OK",
                        3 => "SHORT",
                        4 => "OPEN",
                        _ => "UNKNOWN",
                    };
                    let power_str = match a_power {
                        0 => "OFF",
                        1 => "ON",
                        2 => "DONTKNOW",
                        _ => "UNKNOWN",
                    };
                    defmt::info!("UBX MON-HW: aStatus={} aPower={}", status_str, power_str);
                }
            }
            _ => {
                defmt::trace!(
                    "UBX message class={:#04x} id={:#04x} len={}",
                    self.class,
                    self.id,
                    self.length
                );
            }
        }
    }
}

/// GNSS constellation type
#[derive(Debug, Clone, Copy, Default, Format, PartialEq, Eq)]
#[repr(u8)]
pub enum GnssType {
    #[default]
    Unknown = 0,
    Gps = 1,
    Glonass = 2,
    Galileo = 3,
    BeiDou = 4,
    Qzss = 5,
    Sbas = 6,
}

impl GnssType {
    /// Convert from NMEA talker ID prefix
    pub fn from_talker(talker: &str) -> Self {
        match talker {
            "GP" => GnssType::Gps,
            "GL" => GnssType::Glonass,
            "GA" => GnssType::Galileo,
            "GB" | "BD" => GnssType::BeiDou,
            "GQ" | "QZ" => GnssType::Qzss,
            "GN" => GnssType::Unknown, // Combined, need to check PRN
            _ => GnssType::Unknown,
        }
    }

    /// Infer GNSS type from PRN number (for GN combined sentences)
    pub fn from_prn(prn: u8) -> Self {
        match prn {
            1..=32 => GnssType::Gps,
            33..=64 => GnssType::Sbas,
            65..=96 => GnssType::Glonass,
            // Galileo PRNs in NMEA are typically 1-36 but with GA prefix
            // BeiDou PRNs in NMEA are typically 1-37 but with GB prefix
            _ => GnssType::Unknown,
        }
    }
}

/// Individual satellite information
#[derive(Debug, Clone, Copy, Default)]
pub struct SatelliteInfo {
    /// GNSS constellation type
    pub gnss_type: GnssType,
    /// Satellite PRN/ID number
    pub prn: u8,
    /// Elevation in degrees (0-90)
    pub elevation: u8,
    /// Azimuth in degrees (0-359)
    pub azimuth: u16,
    /// Signal-to-noise ratio in dB-Hz (0-99, 0 = not tracked)
    pub snr: u8,
}

/// Maximum number of satellites we track
pub const MAX_SATELLITES: usize = 24;

/// GPS fix quality
#[derive(Debug, Clone, Copy, Default, Format, PartialEq, Eq)]
pub enum FixQuality {
    #[default]
    Invalid = 0,
    GpsFix = 1,
    DgpsFix = 2,
    PpsFix = 3,
    RtkFixed = 4,
    RtkFloat = 5,
    Estimated = 6,
    Manual = 7,
    Simulation = 8,
}

/// GPS fix type for GSA sentences
#[derive(Debug, Clone, Copy, Default, Format, PartialEq, Eq)]
pub enum FixType {
    #[default]
    NoFix = 1,
    Fix2D = 2,
    Fix3D = 3,
}

/// GPS position data
#[derive(Debug, Clone, Copy, Default)]
pub struct Position {
    pub latitude: f32,
    pub longitude: f32,
    pub altitude: f32,
    pub fix_quality: FixQuality,
    pub satellites: u8,
    pub hdop: f32,
}

impl Position {
    pub fn has_fix(&self) -> bool {
        self.fix_quality != FixQuality::Invalid
    }
}

/// GPS time data
#[derive(Debug, Clone, Copy, Default)]
pub struct Time {
    pub hours: u8,
    pub minutes: u8,
    pub seconds: u8,
    pub milliseconds: u16,
}

/// GPS date data
#[derive(Debug, Clone, Copy, Default)]
pub struct Date {
    pub day: u8,
    pub month: u8,
    pub year: u16,
}

/// Complete GPS data from latest fix
#[derive(Debug, Clone, Copy, Default)]
pub struct GpsData {
    pub position: Position,
    pub time: Time,
    pub date: Date,
    pub speed_knots: f32,
    pub course: f32,
    pub fix_type: FixType,
    /// Satellites in view with their details
    pub satellites_info: [SatelliteInfo; MAX_SATELLITES],
    /// Number of valid entries in satellites_info
    pub satellites_in_view: u8,
}

/// Calculate UBX protocol checksum (8-bit Fletcher)
fn ubx_checksum(data: &[u8]) -> (u8, u8) {
    let mut ck_a: u8 = 0;
    let mut ck_b: u8 = 0;
    for &byte in data {
        ck_a = ck_a.wrapping_add(byte);
        ck_b = ck_b.wrapping_add(ck_a);
    }
    (ck_a, ck_b)
}
