Yatekii/pebble/(commit log)

2025-11-22 initial design
    [pebble.kicad_pcb, pebble.kicad_sch, usb-fast-charger.kicad_sch]
2025-11-23 finalize rev0
    [pebble.kicad_pcb, usb-fast-charger.kicad_sch]
2025-11-24 put charger leds on the back layer, position imu precisely, simplify schema, tapeout
    [bom.csv, designators.csv, pebble.kicad_pcb, pebble.kicad_sch, positions.csv, usb-fast-charger.kicad_sch]
2025-12-16 add nix flake and initial esp32-c6 project structure with probe-rs and defmt
    [bom.csv, designators.csv, pebble.kicad_pcb, pebble.kicad_sch, positions.csv, usb-fast-charger.kicad_sch]
2025-12-16 fruitless tries to talk to the magnetometer
2025-12-17 visualize the leds
2025-12-17 led colors broadcast over BLE properly
2025-12-17 LED goes in a circle now
2025-12-17 render the LEDs
2025-12-17 add ahrs filtering and broadcast it and gps via ble
2025-12-18 add the servo hal and compass functionality
2025-12-19 move shared i2c to a separate module
2025-12-19 move imu constants to a module
2025-12-20 split up magnetometer code and imu code
2025-12-21 document magic calibration numbers
2026-01-07 various fixes to make ui compile again
    [app.rs, ble.rs, data.rs, http.rs, main.rs, mesh.rs, orientation.rs]
2026-01-07 add claude info for imu rotations
2026-01-07 fix: gracefully handle LED initialization failure
    Instead of panicking when LED initialization fails, the firmware now
    continues without LED support. The LED task accepts Option<LedStrip>
    and simply does nothing if LEDs are unavailable.
    This allows the device to remain functional for core features even
    if there's a hardware issue with the LED strip.
    [led.rs, main.rs]
2026-01-07 fix: handle NaN values in chart tick sorting
    partial_cmp returns None for NaN values, which would cause unwrap()
    to panic. Now uses unwrap_or(Equal) to treat NaN values as equal,
    preventing crashes when chart data contains invalid float values.
    [chart.rs]
2026-01-07 fix: remove broken I2C bus scan function
    The scan_i2c_bus function was using self.i2c.write(&[]) which always
    wrote to the fixed BMI270 address instead of scanning different
    addresses. Since this debugging utility was unused and incorrect,
    it's removed to avoid confusion.
    [bmi270.rs]
2026-01-07 firmware: replace unwrap/expect with proper error handling
    - GPS init now returns Result, task handles Option<Gps>
    - Servo timer init now returns Result
    - BLE init uses match instead of expect
    - I2C init uses match instead of expect
    - GATT server creation uses match instead of expect
    - Watch receiver() calls use let-else with error logging
    - All hardware peripherals now gracefully degrade on init failure
    [gps.rs, main.rs, servo.rs]
2026-01-07 gui: replace unwrap/expect with proper error handling
    - HTTP client creation now returns Result, handled in run_app()
    - BLE tokio runtime creation now uses match with error reporting
    [app.rs, ble.rs, http.rs]
2026-01-07 gui: fix O(n) performance bug in IMU data history
    Replace Vec with VecDeque for IMU history storage. This changes
    push operations from O(n) (due to Vec::remove(0) shifting all elements)
    to O(1) using VecDeque::pop_front() and push_back().
    [app.rs, data.rs]
2026-01-07 firmware: add input validation for BLE LED commands
    - Validate LED index (0-71 for individual, or special values 0xFE/0xFF/0xF0-F2)
    - Log warnings for invalid/short commands instead of silently ignoring
    - Use named constants for special LED index values
    - Consistent early-return pattern for validation errors
    [ble.rs]
2026-01-07 firmware: add device status reporting via BLE
    - Add DeviceStatus struct with PeripheralStatus enum for each peripheral
    - Add PeripheralError enum with error codes (InitFailed, I2cError, etc.)
    - Add device_status BLE characteristic (UUID ...defb, 16 bytes)
    - Track init status for LEDs, GPS, servo, IMU, magnetometer
    - Broadcast status after init and notify connected clients
    - Serialize as [status, error] byte pairs for each peripheral
    [ble.rs, main.rs, state.rs]
2026-01-07 gui: add device status panel showing peripheral init status
    - Add DeviceStatusData and PeripheralStatusData structs to parse BLE data
    - Add DEVICE_STATUS_UUID and subscribe to notifications
    - Read device status on connect and display in new panel
    - Create DeviceStatusPanel component with status rows for each peripheral
    - Show OK/ERR status with error details when applicable
    - Integrate panel above puzzle list in right sidebar
    [app.rs, ble.rs, device_status.rs, main.rs]
2026-01-07 firmware: add filter layer and move AHRS from HAL
    Phase 1 of architecture restructure:
    - Create filter/ module for sensor fusion and state computation
    - Move ahrs.rs from hal/ to filter/ with enhanced documentation
    - Add filter/heading.rs with MagCalibration and compute_heading
    - Add filter/device_state.rs with DeviceState and GpsPosition structs
    - Update tasks/imu.rs to use filter module
    - Add architecture documentation to lib.rs and hal/mod.rs
2026-01-07 firmware: move state.rs content to filter/watches.rs
    Phase 2 of architecture restructure:
    - Create filter/watches.rs with organized watch channels
    - Group watches by category (sensor data, commands, status)
    - Add documentation for all types and channels
    - Add ServoCommand type for future use
    - Make state.rs a thin re-export layer for backwards compatibility
2026-01-07 firmware: refactor tasks to be command-driven
    Phase 5 of architecture restructure:
    - LED task now listens to LED_COMMAND watch for updates
    - Servo task now listens to SERVO_COMMAND watch
    - Keep run_compass as separate compass display task
    - Keep run_demo for servo testing
    - Add documentation for task categories
    - Tasks properly handle missing hardware with graceful fallback
    [led.rs, mod.rs, servo.rs]
2026-01-07 firmware: add documentation to math module
    Phase 6 of architecture restructure:
    - Add module-level docs explaining coordinate systems
    - Document sensor orientations on PCB
    - Describe world frame conventions
2026-01-07 firmware: add tests for filter and puzzle modules
    Phase 7 of architecture restructure:
    - Add tests for heading computation (positive, negative, zero)
    - Add tests for magnetometer calibration (update, apply)
    - Add tests for PuzzleId (next, from_u8)
    - Add tests for SavedProgress serialization roundtrip
    - Add tests for PuzzleStateMachine (new, reset, from_saved)
    Note: Tests require target hardware to run via probe-rs
    [state_machine.rs]
2026-01-07 firmware: merge heading.rs into ahrs.rs
    The AHRS already computes tilt-compensated heading via yaw angle.
    - Add Orientation::heading() method for 0-360 normalization
    - Move MagCalibration to ahrs.rs (used before AHRS input)
    - Remove redundant filter/heading.rs module
    - Update IMU task to use orientation.heading()
2026-01-08 firmware: fix GPS DisabledSentence error
    The nmea crate's Nmea::default() doesn't enable any sentence types.
    Use Nmea::create_for_navigation() to enable GGA, GSA, GSV, RMC, VTG, GLL.
    Also:
    - Add debug logging for raw NMEA sentences
    - Change parse error log from trace to warn
    - Use satellites in view count when no fix satellites available
    [gps.rs]
2026-01-08 firmware: fix AHRS magnetometer norm division by zero
    Wait for 50 samples of magnetometer calibration data before running
    AHRS filter. This prevents near-zero calibrated values during warmup
    from causing division by zero in the Madgwick filter normalization.
    [ahrs.rs, imu.rs]
2026-01-08 firmware: revert multi-GNSS and add GPS factory reset
    The CFG-GNSS command was causing GPS malfunction. Revert to GPS-only
    and add a factory reset on init to clear any bad saved configuration.
    [gps.rs]
2026-01-08 firmware: fix GPS NMEA parsing error for empty sentences
    - Reset buffer position and store '$' when starting a new sentence
    - Only buffer bytes after we've seen the '$' start marker
    - Check for minimum sentence length (>6 chars) before parsing
    - Add sentence content to parse error log for debugging
    [gps.rs, main.rs]
2026-01-08 firmware: silence GPS NMEA parse warnings for empty GSV sentences
    - Skip GSV sentences with 0 satellites (nmea crate can't parse them)
    - Downgrade parse errors to debug level (TXT and other unsupported
    sentences are expected to fail)
    [gps.rs]
2026-01-08 firmware: properly handle GSV sentences with 0 satellites
    The nmea crate has a bug where it expects a trailing comma after the
    satellite count, but GSV sentences with 0 satellites end immediately
    at the checksum (e.g., $GPGSV,1,1,00*79).
    Work around by detecting these sentences and logging them at info level
    instead of trying to parse them. The GNTXT warnings are expected since
    text messages aren't enabled for navigation parsing.
    [gps.rs]
2026-01-08 firmware: handle TXT sentences from GPS module
    TXT sentences (like GNTXT with antenna status) are status messages
    that the nmea crate doesn't fully parse. Log them at debug level
    instead of warning about parse failures.
    [gps.rs]
2026-01-08 firmware: revert GPS NMEA parsing to original simple approach
    Reverted overcomplicated workarounds for GSV/TXT parsing. The original
    simple buffering approach works correctly - warnings are expected for
    unsupported sentence types but parsing still works for navigation data.
    [gps.rs]
2026-01-08 firmware: suppress warnings for known NMEA parse failures
    GSV sentences with 0 satellites fail to parse due to nmea crate bug
    (missing trailing comma). TXT sentences are status messages we don't
    need. Suppress warnings for these known cases while keeping warnings
    for unexpected parse failures.
    [gps.rs]
2026-01-08 firmware: fix GSV 0-satellite parsing by adding missing comma
    The nmea crate expects a trailing comma after the satellite count in GSV
    sentences, but GPS modules omit it when there are 0 satellites.
    Fix by detecting these sentences and adding the comma with a recalculated
    checksum before parsing. TXT sentences are still filtered as they're
    status messages not needed for navigation.
    [gps.rs]
2026-01-08 firmware: remove TXT sentence filtering - warn on all parse errors
    [gps.rs]
2026-01-08 feat: add multi-GNSS support and satellite info display
    Firmware:
    - Enable GPS + Galileo + BeiDou constellations via CFG-GNSS command
    - Add GnssType enum and SatelliteInfo struct for satellite details
    - Parse satellite data from NMEA GSV sentences (PRN, elevation, azimuth, SNR)
    - Add BLE characteristics for satellite info (2 chunks of 12 satellites each)
    - Broadcast satellite data via watch channels
    GUI:
    - Add satellite info panel above map view
    - Display signal strength bars color-coded by constellation
    - Show legend with constellation counts (GPS, GAL, BDS, GLO)
    - Update map overlay to show satellites in view instead of fix count
    [app.rs, ble.rs, gps.rs, main.rs, map.rs, watches.rs]
2026-01-09 firmware: fix CFG-GNSS to include all 7 GNSS systems
    The MAX-M8Q module requires all 7 GNSS systems to be configured in the
    CFG-GNSS command. The previous 5-block configuration was being rejected
    (NAK), causing the module to use factory defaults (GPS + GLONASS only).
    Now correctly configures:
    - GPS: Enabled (8-16 channels)
    - SBAS: Disabled
    - Galileo: Enabled (4-8 channels)
    - BeiDou: Enabled (8-16 channels)
    - IMES: Disabled
    - QZSS: Disabled
    - GLONASS: Disabled (to stay within 3 concurrent GNSS limit)
    [gps.rs]
2026-01-09 firmware: add gyroscope bias calibration to fix AHRS yaw drift
    The AHRS yaw was drifting continuously when the device was stationary
    due to uncorrected gyroscope bias. This commit adds:
    - GyroCalibration struct that computes average gyro bias during a
    4-second warmup period while the device is stationary
    - Bias correction is applied to all subsequent gyroscope readings
    - Removed magnetometer hard iron calibration (requires device rotation
    which we don't have during static warmup)
    The Madgwick filter with BETA=0.1 now produces stable orientation
    output when the device is not moving.
    [ahrs.rs, imu.rs]
2026-04-12 firmware: add mag calibration mode, hard/soft iron correction, and outlier filter
    - Add MAG_CALIBRATING mode that streams raw, OTP-comp, and fw-calibrated
    values over RTT as 9 integers for the mag-calibrate desktop tool
    - Update MAG_HI_OFFSET and MAG_SOFT_IRON to freshly calibrated values
    - Fix fw-cal diagnostic to use OTP-compensated values (matching the normal
    heading path), not raw ADC values — this was the source of the ~200 µT
    offset visible in row 3 of the calibration tool
    - Reject mag readings outside MAG_FIELD_CENTER ± MAG_FIELD_TOLERANCE after
    calibration to suppress noise spikes
    [imu.rs]
2026-04-16 LED pointing north
2026-04-16 firmware: add software tap detection via accelerometer
    Detect knocks on the PCB by watching for short acceleration spikes
    (> 2.5 g, < 100 ms duration) in the existing 100 Hz IMU polling loop.
    Confirmed taps increment a counter broadcast on a new TAP_EVENT Watch
    channel and are logged via RTT. Silenced the per-sample heading/acc
    info! logs so tap messages are clearly visible.
    [events.rs, imu.rs, watches.rs]
2026-04-16 firmware: add double-tap detection
    Extend the tap detector state machine with a BetweenTaps state:
    after the first spike resolves, a 300 ms window is opened waiting
    for a second spike. A second short impulse in that window fires
    DoubleTap; an expired window fires SingleTap. Adds DOUBLE_TAP_EVENT
    Watch channel and PuzzleEvent::DoubleTap alongside the existing
    single-tap plumbing. RTT logs "tap: single" / "tap: double".
    [events.rs, imu.rs, watches.rs]
2026-04-16 firmware: fix BMM350_TO_BOARD Z sign for correct tilt compensation
    Empirically verified that the BMM350 OTP-compensated output reports +z
    upward (the reported sensor frame is effectively left-handed after
    Bosch's internal axis remapping), so board +Z = +sensor_z despite the
    chip's physical z-axis pointing into the PCB.
    With the previous -1.0 sign, a northward upward tilt produced a 180°
    heading error because the vertical Earth field component was subtracted
    instead of added during tilt compensation. Forward and backward tilt
    now work correctly.
    [math.rs]
2026-04-16 firmware: flash LED ring on tap events
    Extend run_compass to also wait on TAP_EVENT and DOUBLE_TAP_EVENT via
    select3. A single tap flashes the ring white once (80ms on/off); a double
    tap flashes twice. Compass display is restored after each flash.
2026-04-16 firmware: cap LED brightness at 1/3 in HAL, tap flash at 1/6
    The HAL now divides brightness_level by 3 before writing to the strip,
    capping the physical output at ~85/255 regardless of what callers
    request. The tap flash passes 128, which after the /3 scaling lands at
    ~42 (~1/6 of full scale).
2026-04-16 firmware: move brightness cap into set_brightness, fix default
    The /3 cap was applied in show() which meant any show() call before
    set_brightness() would use the default brightness_level of 255, sending
    full brightness to the strip. Moving the division into set_brightness()
    means the stored value is always the physical value, so no code path
    can accidentally bypass the cap. Also change the default from 255 to 0
    so any pre-init show() is safe. Adds a defmt::trace of the brightness
    on each show() to confirm the effective value via RTT.
    [led.rs]
2026-04-17 firmware: replace /3 brightness cap with tunable MAX_BRIGHTNESS=8
    stored=42 (the previous /3 cap) is still blinding on WS2812B-2020 at
    close range. Replace with a named MAX_BRIGHTNESS constant that scales
    the 0-255 caller range onto 0-8, giving ~3% of full physical drive.
    Easy to raise once the right level is found empirically.
    [led.rs]
2026-07-05 firmware: fix all clippy findings so lint passes
    Resolve the deny-level collapsible_match in main.rs and the 8 lib-level
    warnings (excessive_precision, needless_borrow, manual_range_contains,
    manual_is_multiple_of, manual abs_diff). cargo clippy now passes clean.
    Closes #2
    [bmm350.rs, gps.rs, i2c.rs, imu.rs, main.rs, storage.rs]
2026-07-05 firmware: extract BLE peripheral from main.rs; drop dead comms::messages
    Move the host runner, connection loop, notification futures, and LED
    characteristic mirror out of main.rs into tasks::ble::run(), deduplicating
    the led_control payload into a helper. main.rs shrinks from 618 to ~260
    lines and now just wires tasks together.
    Delete comms::messages: a protocol-agnostic message layer with zero
    consumers (the BLE path talks to the watch channels directly).
    Behavior-preserving restructuring only. Refs #11, #12.
2026-07-05 firmware: wire puzzle FSM into runtime (keystone #3)
    Add tasks::puzzle, spawned from main, that owns PuzzleStateMachine,
    turns COMPASS_HEADING/TAP_EVENT/DOUBLE_TAP_EVENT watch updates into
    PuzzleEvents, and bridges returned Actions onto SERVO_COMMAND (finally
    giving it a sender) and LED_COMMAND.
    Only CompassAlign is dispatched today; LocationFind/TiltSequence and
    full enum dispatch come with #7, GPS->DeviceState with #5, and the LED
    ring renderer with #8/#10.
    Also fix NUM_PUZZLES off-by-one: Unlocked is a terminal state, not a
    puzzle (4->3, which also fixes a latent 17-byte write into a 16-byte
    buffer in SavedProgress::to_bytes), and add all_solved() over the real
    puzzles only.
    Co-Authore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
    [main.rs, mod.rs, puzzle.rs, state_machine.rs]
2026-07-05 firmware: fix compass tilt compensation (issue #1)
    Tilt-compensated heading was wrong under any non-flat orientation (flat
    "worked" only because roll=pitch=0 makes the tilt rotation the identity).
    Two independent bugs, both required:
    - r_tilt was an invalid de-rotation matrix. Replace with R = Ry(pitch)·Rx(roll),
    verified by forward simulation to be tilt-invariant (0.00° error) and confirmed
    on-device to correctly rotate measured gravity back to vertical.
    - BMM350_TO_BOARD Z row was +sensor_z, making the transform a reflection (det = −1)
    inconsistent with the accelerometer's proper-rotation frame. Right-hand rule with
    the verified X/Y rows forces −sensor_z (det = +1). The old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
    [imu.rs, led.rs, math.rs, watches.rs]
2026-07-05 firmware: add I2C software timeout to stop bus-lockup freeze
    The blocking I2C driver had no timeout (SoftwareTimeout::None), so a wedged
    bus made wait_for_completion_blocking spin forever. Because it's polled inside
    the async executor, a single stuck transaction froze the entire firmware
    (observed hanging in BMI270 read → write_read → all_commands_done).
    Set a 10 ms per-transaction software timeout. A register read is ~0.3 ms at
    400 kHz, so this only trips on a real lockup; the IMU loop already treats a
    failed read as a skipped sample.
    [imu.rs]
2026-07-05 gui: reqwest/rustls http + fix BLE telemetry drop
    Replace isahc (curl+openssl) with reqwest+rustls for tile loading, run
    requests on an owned tokio runtime so gpui's executor can drive them
    (hyper needs a reactor).
    Fix telemetry never arriving: firmware notified all 4 sensor
    characteristics per 100Hz IMU sample (~400 pkt/s), saturating the BLE
    link and starving CCCD-write responses so subscriptions dropped
    mid-connect. Throttle+coalesce sensor notifications to ~50Hz.
    gui BLE: bound connect() with a 10s timeout so a wedged peripheral
    retries instead of hanging; collapse duplicated subscribe blocks.
    flake: darwin xcrun shim routing metal/metallib to the mounted Metal
    Toolchain cryptex (Xcod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
    [app.rs, ble.rs, http.rs, map.rs, puzzles.rs]
2026-08-15 firmware: retry IMU init on bus timeout; servo demo holds open
    - IMU init now retries up to 5x with a 100ms delay before panicking,
    since the I2C bus can time out on a cold boot.
    - Spawn the servo demo task and hold it at the open position for
    bench testing.
2026-08-15 firmware: tap toggles servo; open angle to 180°
    - Run the servo command handler (not the bench demo) so tap events
    actually drive the servo via SERVO_COMMAND.
    - Map ServoPosition::Unlocked to 180° to match the calibrated open
    position; Locked stays at 0°.
